saghya/drawingBoard/Hardware/BOM/SághyAttila_11.xlsx

Item # | Supplier | Reference | Name | Quantity
1 | Farnell | 2469525 | PTV09A-4020F-B104 | 2
2 | Lomex | 87-06-35 | 74HCT245D | 1
3 | Lomex | 87-05-95 | 74HCT244D | 1
4 | Lomex | 82-13-46 | Capacitor | 10
5 | Lomex | 37-00-81 | RG12864B-BIW-V | 1
6 | Lomex | 86-00-97 | 2N7002 | 1
7 | Lomex | 80-10-98 | Resistor | 10
8 | Lomex | 80-10-74 | Resistor | 10
9 | Lomex | 80-10-86 | Resistor | 15
10 | Lomex | 45-05-43 | Tactile Switch | 3
11 | Lomex | 05-05-89 | RKT3296-103-W | 1
12 | Tanszék | NUCLEO | Nucleo F446RE | 1
13 | Lomex | 43-00-08 | LCD hüvely | 1
