saghya/drawingBoard/Hardware/hallglib.xlsx

Item # | Column=Supplier | Column=Reference | Column=Name | Column=Quantity
1
2
3
