saghya/drawingBoard/Hardware/drawingBoard.pdf

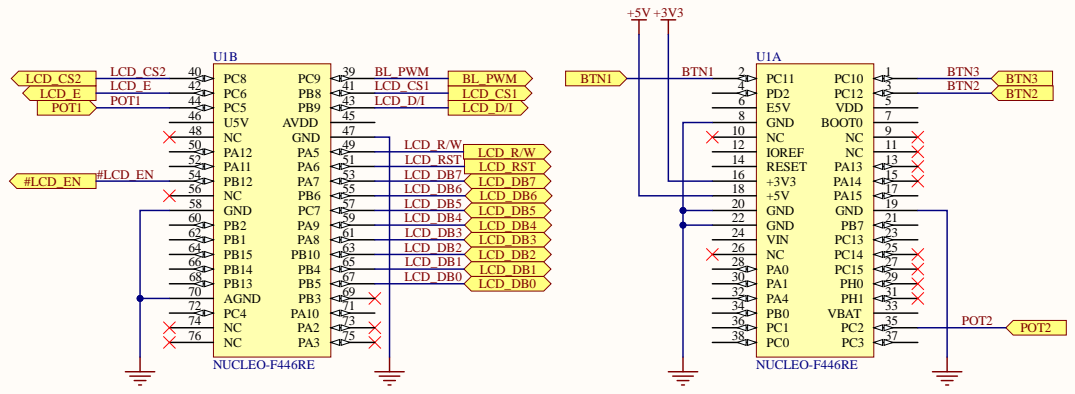
[picture p14: page 1]

1 8
2 0

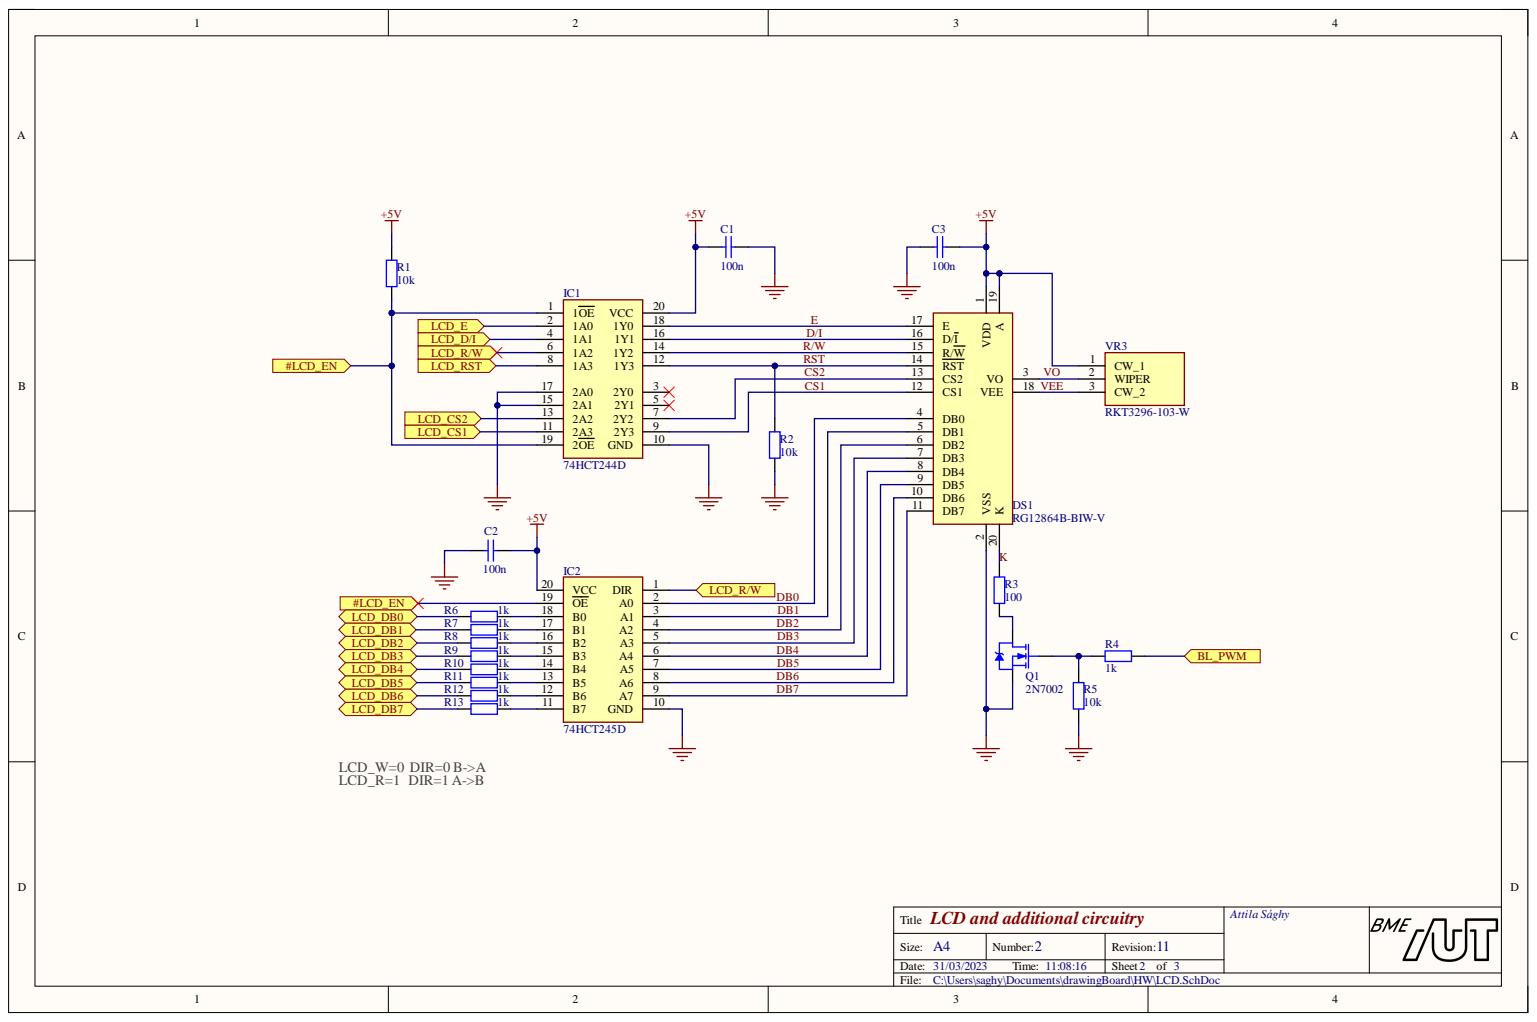
[picture p15: page 2]

4 | 1 6 I 1 6
6 | 1 4 R/ W 1 5

1 5 | 5 | | | 4
1 3 1 1 1 9 | 7

1 0 | | R2 | 6

1 0
1 1

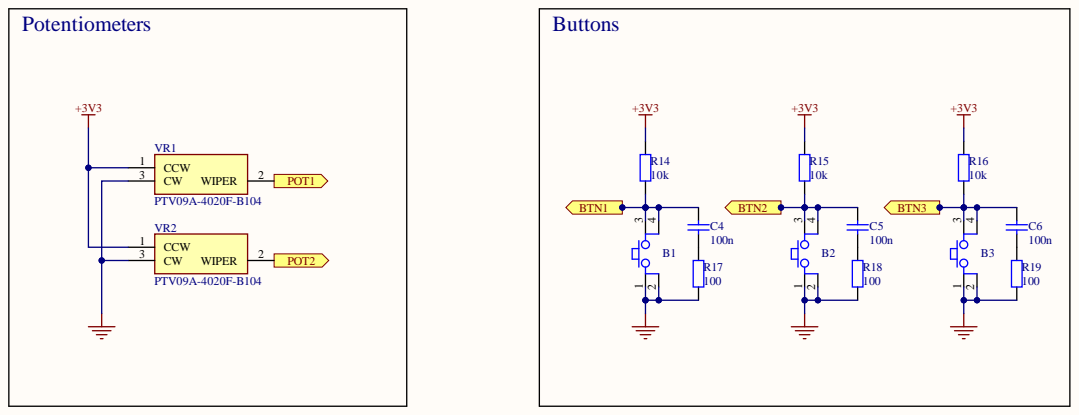
[picture p16: page 3]

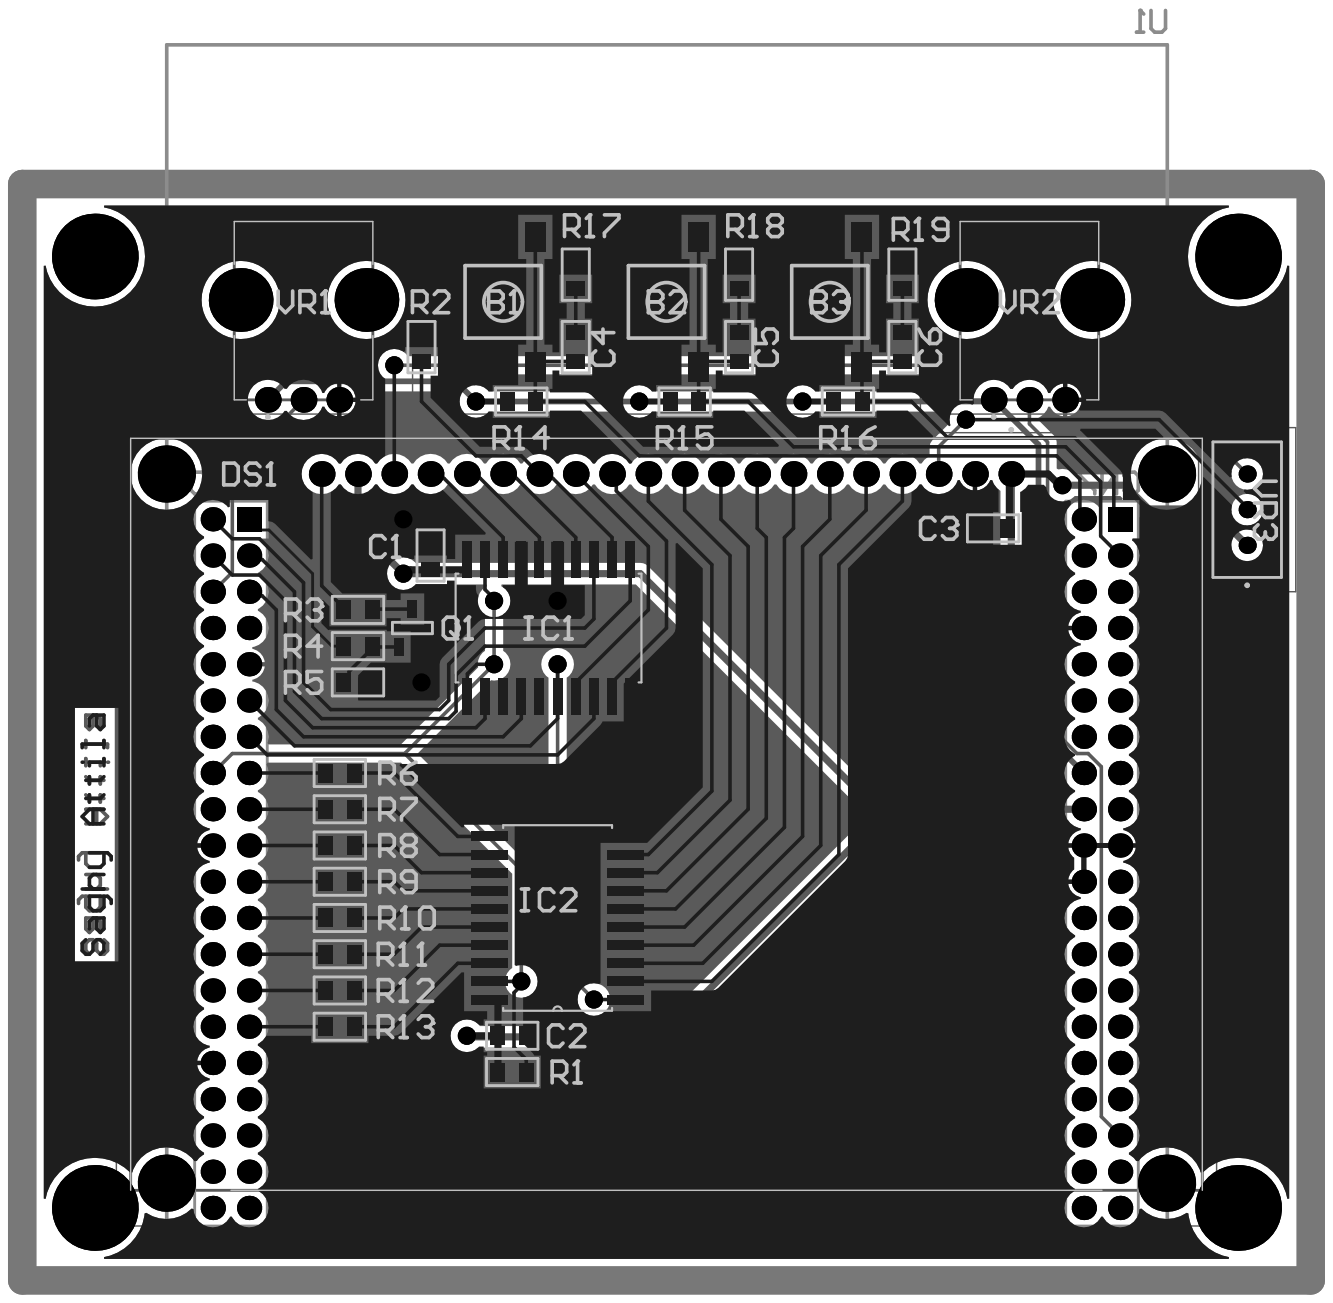
[picture p17: page 4]

Item # | Supplier | Reference | Name | Description | Quantity
1 | Farnell | 2469525 | PTV09A-4020F-B104 | Variable Resistor | 2
2 | Lomex | 05-05-89 | RKT3296-103-W | Variable Resistor | 1
3 | Lomex | 37-00-81 | RG12864B-BIW-V | Display | 1
4 | Lomex | 45-05-43 | FSM4JSMA | Tactile Switch | 3
5 | Lomex | 80-10-74 | 100 | Resistor | 4
6 | Lomex | 80-10-86 | 1k | Resistor | 9
7 | Lomex | 80-10-98 | 10k | Resistor | 6
8 | Lomex | 82-13-46 | 100n | Capacitor | 6
9 | Lomex | 86-00-97 | 2N7002 | NMOS | 1
10 | Lomex | 87-05-95 | 74HCT244D | Buffer/Line driver | 1
11 | Lomex | 87-06-35 | 74HCT245D | Bidirectional bus transceiver | 1
12 | Tanszék | NUCLEO | NUCLEO-F446RE | Development kit | 1
13 | Lomex | 43-00-08 | hüvely | LCD hüvely | 1
