saghya/drawingBoard/Hardware/PDF/drawingBoard.PDF

C:\Users\saghy\Documents\drawingBoard\HW\Nucleo.SchDoc

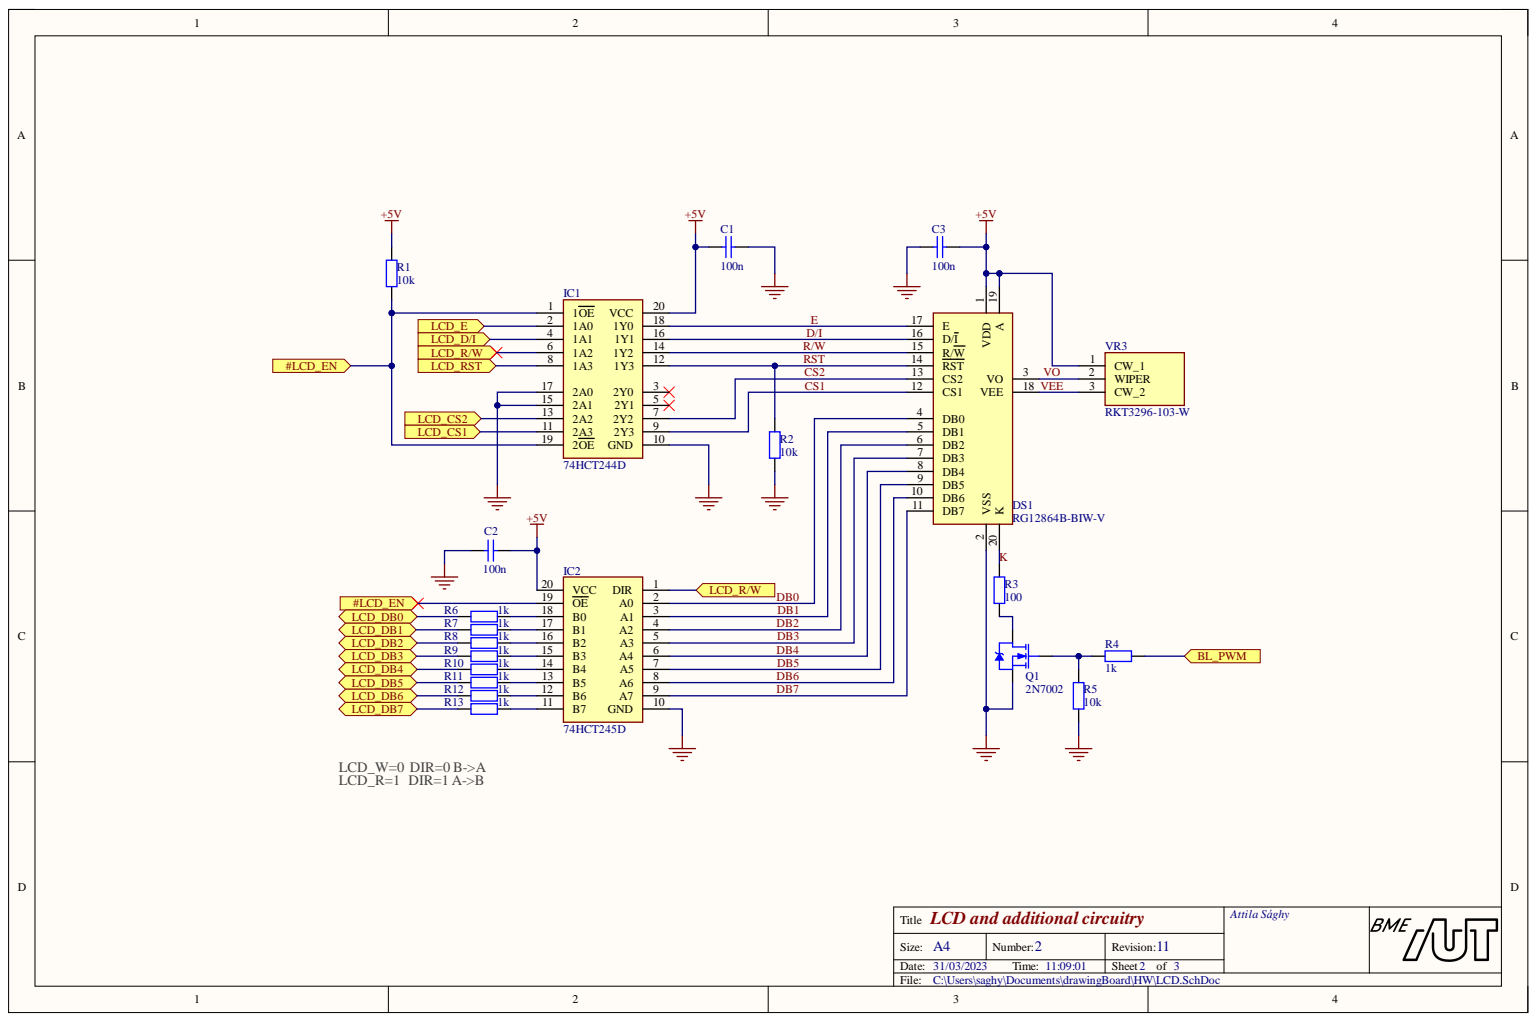
[picture p18: page 2]

4 | 1 6 I 1 6
6 | 1 4 R/ W 1 5

1 5 | 5 | | | 4
1 3 1 1 1 9 | 7

1 0 | | R2 | 6

1 0
1 1


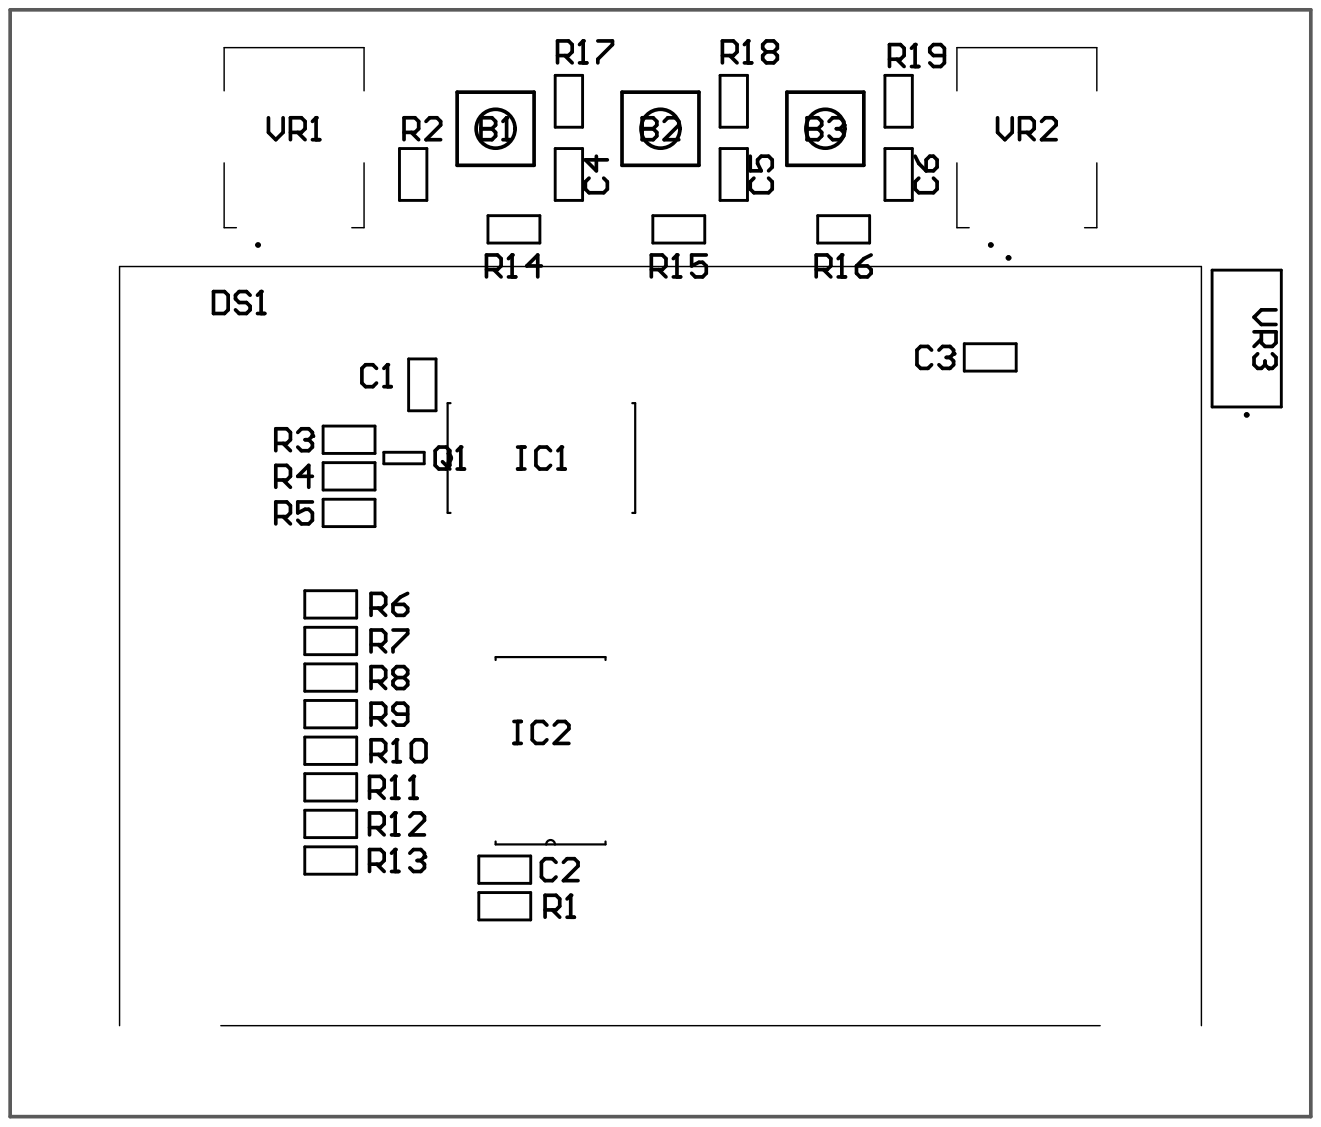
[picture p19: page 4]

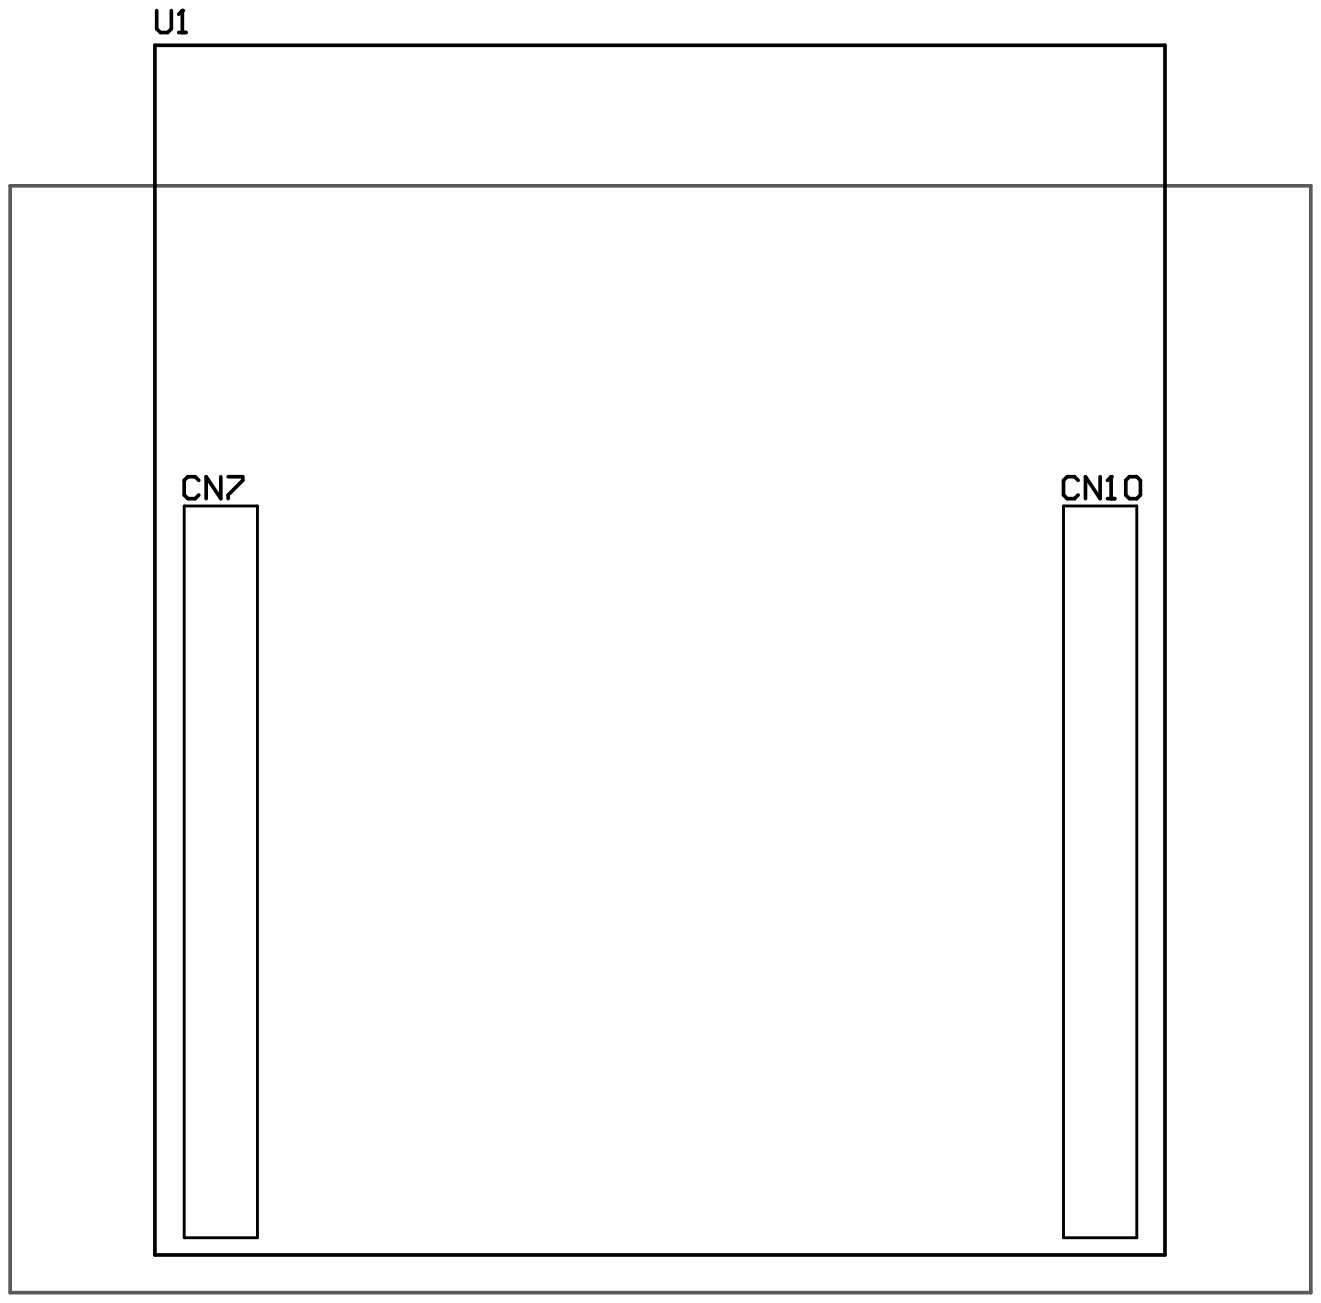
[picture p20: page 5]

Designator | Reference | Name | Quantity | Footprint | Supplier
B1, B2, B3 | 45-05-43 | Tactile Switch | 3 FP_BTN_SMD | | Lomex
C1, C2, C3, C4, C5, C6 | 82-13-46 | Capacitor | 6 FP_0805_CAP_085 Lomex
DS1 | 37-00-81 | RG12864B-BIW-V | 1 RG12864BBIWV | | Lomex
IC1 | 87-05-95 | 74HCT244D | 1 SOIC127P1032X26 | 5-20N | Lomex
IC2 | 87-06-35 | 74HCT245D | 1 SOIC127P1032X26 | 5-20N | Lomex
Q1 | 86-00-97 | 2N7002 | 1 FP_SOT23-3 | | Lomex
R1, R2, R5, R14, R15, R16 | 80-10-98 | Resistor | 6 FP_0805_RES | | Lomex
R3, R17, R18, R19 | 80-10-74 | Resistor | 4 FP_0805_RES | | Lomex
R4, R6, R7, R8, R9, R10, R11, R12, R13 | 80-10-86 | Resistor | 9 FP_0805_RES | | Lomex
U1 | NUCLEO | Nucleo F446RE | 1 FP_NUCLEO- | 64_2x20 | Tanszék
VR1, VR2 | 2469525 | PTV09A-4020F-B104 | 2 PTV09A4020FB103 Farnell
VR3 | 05-05-89 | RKT3296-103-W | 1 RKT3296103W | | Lomex
