saghya/drawingBoard/(list of files, drawings)

Other design files:
Hardware/drawingBoard.PcbDoc
Hardware/drawingBoard.PrjPcb
Hardware/hallglib.SchLib
Hardware/hazi_kiindulas.PcbDoc
Hardware/Inputs.SchDoc
Hardware/LCD.SchDoc
Hardware/Nucleo.SchDoc
