saghya/drawingBoard/Firmware/Core/Src/main.c

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
/* Includes ------------------------------------------------------------------*/
#include "main.h"

/* USER CODE BEGIN Includes */
#include "state.h"
#include "menu.h"
#include "drawing.h"
#include "brightness.h"
#include "flash.h"
#include "stm32f446xx.h"
/* USER CODE END Includes */

ADC_HandleTypeDef hadc1;
ADC_HandleTypeDef hadc2;
DMA_HandleTypeDef hdma_adc1;
DMA_HandleTypeDef hdma_adc2;

TIM_HandleTypeDef htim1;
TIM_HandleTypeDef htim8;

UART_HandleTypeDef huart2;

void        SystemClock_Config(void);
static void MX_GPIO_Init(void);
static void MX_DMA_Init(void);
static void MX_ADC1_Init(void);
static void MX_USART2_UART_Init(void);
static void MX_TIM8_Init(void);
static void MX_ADC2_Init(void);
static void MX_TIM1_Init(void);
/* USER CODE BEGIN PFP */
void delay_us(uint16_t us);
/* USER CODE END PFP */

/* USER CODE BEGIN 0 */
void delay_us(uint16_t us)
{
    __HAL_TIM_SET_COUNTER(&htim1, 0); // set the counter value a 0
    while (__HAL_TIM_GET_COUNTER(&htim1) < us)
        ; // wait for the counter to reach the us input in the parameter
}
/* USER CODE END 0 */

/**
 * @brief  The application entry point.
 * @retval int
 */
int main(void)
{
    /* MCU
     * Configuration--------------------------------------------------------*/

    /* Reset of all peripherals, Initializes the Flash interface and the
     * Systick. */
    HAL_Init();

    /* Configure the system clock */
    SystemClock_Config();

    /* Initialize all configured peripherals */
    MX_GPIO_Init();
    MX_DMA_Init();
    MX_ADC1_Init();
    MX_USART2_UART_Init();
    MX_TIM8_Init();
    MX_ADC2_Init();
    MX_TIM1_Init();
    /* USER CODE BEGIN 2 */
    HAL_TIM_Base_Start(&htim1);
    HAL_UART_Receive_IT(&huart2, &Rx_byte, 1);
    LCD_Init();
    /* USER CODE END 2 */

    /* Infinite loop */
    /* USER CODE BEGIN WHILE */
    while (1) {
        switch (state) {
            case S_MENU:
                menuLoop();
                break;
            case S_DRAWING:
                drawingLoop();
                break;
            case S_SAVE:
                saveDrawing();
                break;
            case S_CHANGE_BRIGHTNESS:
                brightnessLoop();
                break;
        }
        /* USER CODE END WHILE */

        /* USER CODE BEGIN 3 */
    }
    /* USER CODE END 3 */
}

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
