saghya/drawingBoard/Firmware/drawingBoard.ioc

Mcu.UserName=STM32F446RETx
PA13.GPIO_Label=TMS
PA13.Signal=SYS_JTMS-SWDIO
PA14.GPIO_Label=TCK
PA14.Signal=SYS_JTCK-SWCLK
PA2.GPIO_Label=USART_TX
PA2.Signal=USART2_TX
PA3.GPIO_Label=USART_RX
PA3.Signal=USART2_RX
PA5.GPIO_Label=LCD_R/W
PA5.Signal=GPIO_Output
PA6.GPIO_Label=LCD_RST
PA6.Signal=GPIO_Output
PA7.GPIO_Label=LCD_DB7
PA7.Signal=GPIO_Output
PA8.GPIO_Label=LCD_DB3
PA8.Signal=GPIO_Output
PA9.GPIO_Label=LCD_DB4
PA9.Signal=GPIO_Output
PB10.GPIO_Label=LCD_DB2
PB10.Signal=GPIO_Output
PB12.GPIO_Label=xLCD_EN
PB12.Signal=GPIO_Output
PB3.GPIO_Label=SWO
PB3.Signal=SYS_JTDO-SWO
PB4.GPIO_Label=LCD_DB1
PB4.Signal=GPIO_Output
PB5.GPIO_Label=LCD_DB0
PB5.Signal=GPIO_Output
PB6.GPIO_Label=LCD_DB6
PB6.Signal=GPIO_Output
PB8.GPIO_Label=LCD_CS1
PB8.Signal=GPIO_Output
PB9.GPIO_Label=LCD_D_I
PB9.Signal=GPIO_Output
PC10.GPIO_Label=BTN1
PC10.Signal=GPXTI10
PC11.GPIO_Label=BTN3
PC11.Signal=GPXTI11
PC12.GPIO_Label=BTN2
PC12.Signal=GPXTI12
PC14-OSC32_IN.Signal=RCC_OSC32_IN
PC15-OSC32_OUT.Signal=RCC_OSC32_OUT
PC2.GPIO_Label=POT1
PC2.Signal=ADCx_IN12
PC5.GPIO_Label=POT2
PC5.Signal=ADCx_IN15
PC6.GPIO_Label=LCD_E
PC6.Signal=GPIO_Output
PC7.GPIO_Label=LCD_DB5
PC7.Signal=GPIO_Output
PC8.GPIO_Label=LCD_CS2
PC8.Signal=GPIO_Output
PC9.GPIO_Label=LCD_BL_PWM
PC9.Signal=S_TIM8_CH4
PH0-OSC_IN.Signal=RCC_OSC_IN
PH1-OSC_OUT.Signal=RCC_OSC_OUT
