saghya/drawingBoard/Firmware/Core/Inc/main.h

#define POT1_Pin GPIO_PIN_2
#define POT1_GPIO_Port GPIOC
#define USART_TX_Pin GPIO_PIN_2
#define USART_TX_GPIO_Port GPIOA
#define USART_RX_Pin GPIO_PIN_3
#define USART_RX_GPIO_Port GPIOA
#define LCD_R_W_Pin GPIO_PIN_5
#define LCD_R_W_GPIO_Port GPIOA
#define LCD_RST_Pin GPIO_PIN_6
#define LCD_RST_GPIO_Port GPIOA
#define LCD_DB7_Pin GPIO_PIN_7
#define LCD_DB7_GPIO_Port GPIOA
#define POT2_Pin GPIO_PIN_5
#define POT2_GPIO_Port GPIOC
#define LCD_DB2_Pin GPIO_PIN_10
#define LCD_DB2_GPIO_Port GPIOB
#define xLCD_EN_Pin GPIO_PIN_12
#define xLCD_EN_GPIO_Port GPIOB
#define LCD_E_Pin GPIO_PIN_6
#define LCD_E_GPIO_Port GPIOC
#define LCD_DB5_Pin GPIO_PIN_7
#define LCD_DB5_GPIO_Port GPIOC
#define LCD_CS2_Pin GPIO_PIN_8
#define LCD_CS2_GPIO_Port GPIOC
#define LCD_BL_PWM_Pin GPIO_PIN_9
#define LCD_BL_PWM_GPIO_Port GPIOC
#define LCD_DB3_Pin GPIO_PIN_8
#define LCD_DB3_GPIO_Port GPIOA
#define LCD_DB4_Pin GPIO_PIN_9
#define LCD_DB4_GPIO_Port GPIOA
#define TMS_Pin GPIO_PIN_13
#define TMS_GPIO_Port GPIOA
#define TCK_Pin GPIO_PIN_14
#define TCK_GPIO_Port GPIOA
#define BTN1_Pin GPIO_PIN_10
#define BTN1_GPIO_Port GPIOC
#define BTN1_EXTI_IRQn EXTI15_10_IRQn
#define BTN3_Pin GPIO_PIN_11
#define BTN3_GPIO_Port GPIOC
#define BTN3_EXTI_IRQn EXTI15_10_IRQn
#define BTN2_Pin GPIO_PIN_12
#define BTN2_GPIO_Port GPIOC
#define BTN2_EXTI_IRQn EXTI15_10_IRQn
#define SWO_Pin GPIO_PIN_3
#define SWO_GPIO_Port GPIOB
#define LCD_DB1_Pin GPIO_PIN_4
#define LCD_DB1_GPIO_Port GPIOB
#define LCD_DB0_Pin GPIO_PIN_5
#define LCD_DB0_GPIO_Port GPIOB
#define LCD_DB6_Pin GPIO_PIN_6
#define LCD_DB6_GPIO_Port GPIOB
#define LCD_CS1_Pin GPIO_PIN_8
#define LCD_CS1_GPIO_Port GPIOB
#define LCD_D_I_Pin GPIO_PIN_9
#define LCD_D_I_GPIO_Port GPIOB
