saghya/drawingBoard/(commit log)

2023-04-30 lcd driver
2023-04-30 clean up
    [Inputs.SchDoc, LCD.SchDoc, Nucleo.SchDoc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]
2023-05-05 gpio interrupt
2023-05-10 Revert "ioc"
    This reverts commit 4f384ee85add26dd70dd3298ce008e6861593d90.
    asd
    [drawingBoard.ioc]
2023-05-10 disable interrupt with timer
2023-05-12 cleanup and getting ready to send/receive via uart
2023-05-16 simplify uart callback function
